acamilo/Motherboard_Controller/SmallKat v2.kicad_pcb

## KiCad design SmallKat v2.kicad_pcb (2020-02-04)

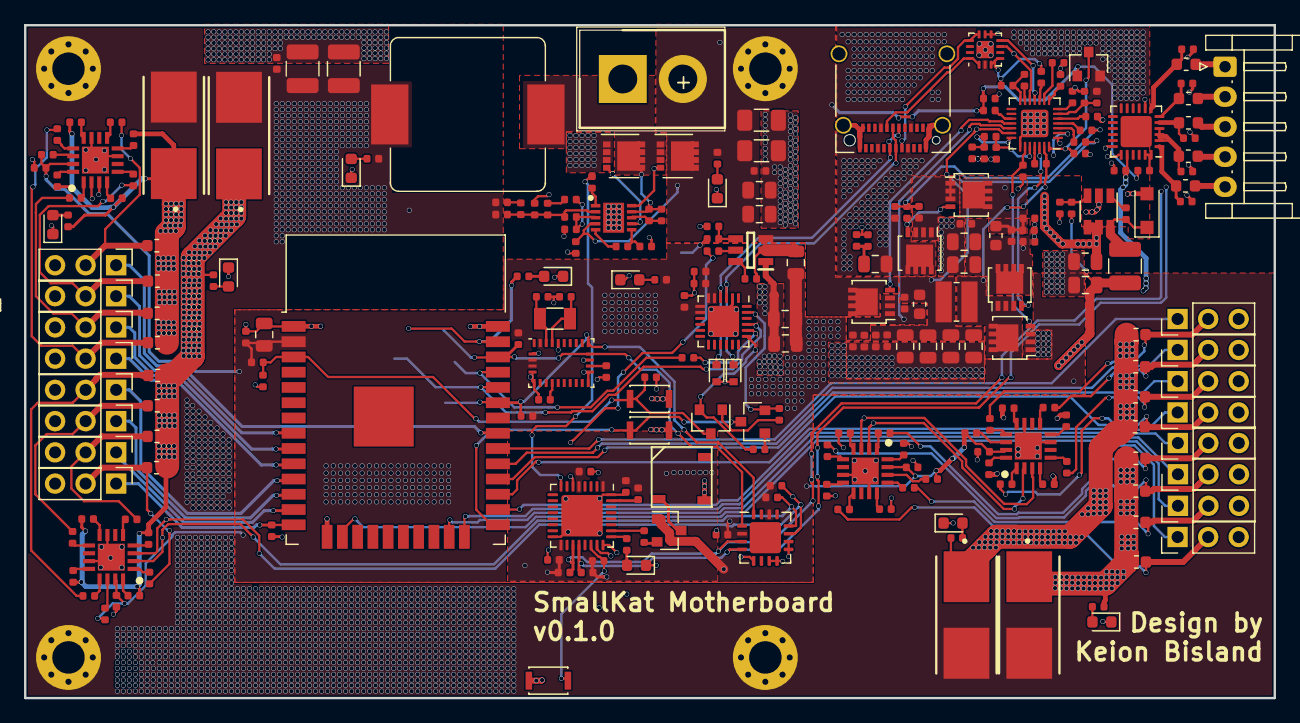
[picture p1: board SmallKat v2.kicad_pcb from above]

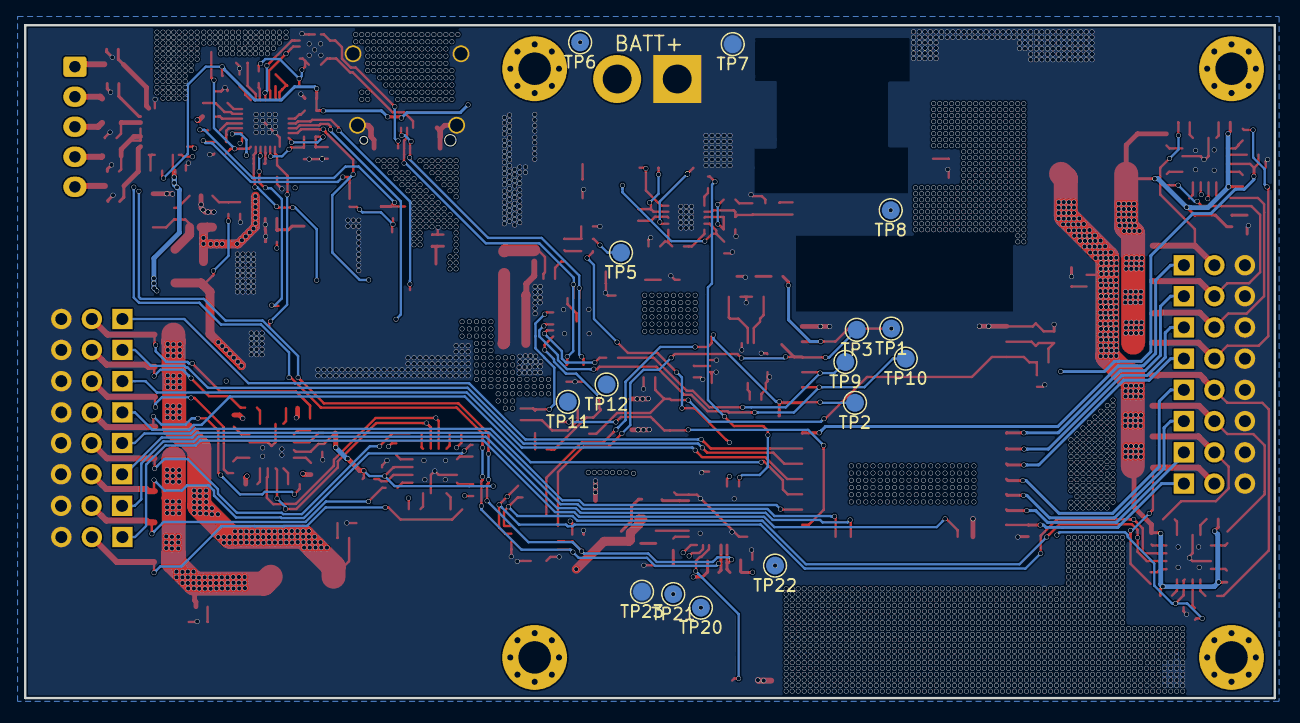
[picture p2: board SmallKat v2.kicad_pcb from below]

Board: 4 copper layers, 104.0 x 56.0 mm, 272 parts (15 on the bottom side), 177 nets.

Parts:
BZ1: Buzzer; KLJ-5030
C1, C2, C35, C63, C66: 10uF; C_0805_2012Metric
C3, C5, C24, C72, C75, C76, C77: 22uF; C_0805_2012Metric
C4, C6, C7, C17, C20, C25, C26, C28, C29, C31, C32, C37, C45, C46, C49, C51, C52, C53, C54, C55, C57, C59, C64, C70, C71, C73, C78, C79, C80: 0.1uF; C_0402_1005Metric
C8, C9: 10pF; C_0402_1005Metric
C10: 1000pF; C_0402_1005Metric
C11, C56, C58: 100pF; C_0402_1005Metric
C12: 10nF; C_0402_1005Metric
C13, C22, C50, C60, C61, C65, C81, C82: 1uF; C_0402_1005Metric
C14, C27: 4.7uF; C_0402_1005Metric
C15: 470nF; C_0402_1005Metric
C16, C18: 10uF; C_1206_3216Metric
C19, C21: 100uF; C_1210_3225Metric
C23, C47: 2.2uF; C_0805_2012Metric
C48: 2200pF; C_0402_1005Metric
C62: 0.01uF; C_0402_1005Metric
C67: 470pF; C_0402_1005Metric
C68: 0.047uF; C_0402_1005Metric
C69, C74: 10uF; C_0402_1005Metric
D1, D2, D3, D4, D18, D23, D24, D25, D26: LED; LED_0603_1608Metric
D5: BAT54C; SOT-23
D7, D8: D_TVS; D_SOD-523
D17: MA2YD26; D_SOD-123F
F1, F2, F3, F4: Fuse; 0154.250DR
H1, H2, H3, H4: MountingHole_Pad; MountingHole_2.7mm_M2.5_Pad_Via
IC1: TPS562201DDCR; SOT95P280X110-6N
IC2: TPS40192DRCT; SON50P300X300X100-11N
IC4, IC5, IC6, IC7: MAX34409ETE+; QFN65P400X400X80-17N
J1, J2, J3, J4, J5, J6, J7, J8, J10, J11, J12, J13, J14, J15, J16, J17: Conn_01x03_Male; PinHeader_1x03_P2.54mm_Vertical
J9: Conn_01x02_Male; SHDR2W320P716_1X2_1574X813X1588P
J19: USB_C_Receptacle; USB_C_Receptacle_Amphenol_12401610E4-2A_CircularHoles
J21: Conn_01x05_Male; JST_EH_S5B-EH_1x05_P2.50mm_Horizontal
L1: 4.7uH; L_0805_2012Metric
L2: 1uH; L_Bourns_SRP1245A
L3: 15uH; L_1210_3225Metric
L4: L; L_Wuerth_MAPI-3020
Q1, Q2: BUK9M120-100EX; VSON-8_3.3x3.3mm_P0.65mm_NexFET
Q3, Q4: MMBT3904; SOT-23
Q7: 2N3905; SOT-23
Q8, Q9: BUK9M120-100EX; LFPAK33
Q10, Q11: CSD17307Q5A; LFPAK33
Q12: Si7141DP; LFPAK33
R1, R7, R44: 330R; R_0402_1005Metric
R2: 1K; R_0402_1005Metric
R3: 3.4K; R_0402_1005Metric
R4, R5, R8, R10, R11, R21, R25, R26, R27, R43, R45, R46, R47, R48, R56, R117, R119, R125, R126, R127: 10K; R_0402_1005Metric
R6: 120K; R_0402_1005Metric
R9: 33.2K; R_0402_1005Metric
R12: 2.18k; R_0402_1005Metric
R13: 20k; R_0402_1005Metric
R14: 2.61k; R_0402_1005Metric
R15: 4.22k; R_0402_1005Metric
R16: 3.9k; R_0402_1005Metric
R17, R18, R19: 100k; R_0402_1005Metric
R20, R63, R73, R78, R86: 20K; R_0402_1005Metric
R22, R23, R37, R38, R124: 47R; R_0603_1608Metric
R24: 470R; R_0402_1005Metric
R49, R52: 3.9K; R_0402_1005Metric
R50: 430K; R_0402_1005Metric
R51: 66.5K; R_0402_1005Metric
R53: 4.7R; R_0402_1005Metric
R54, R55: 4.02K; R_0402_1005Metric
R57, R61, R62, R69, R70, R74, R75, R79, R80, R87, R88, R91, R92, R99, R100, R104, R105, R123: 0.01R; R_0603_1608Metric
R58: 30.1K; R_0402_1005Metric
R59, R60, R64, R65, R67, R68, R71, R72, R76, R77, R81, R82, R84, R85, R89, R90, R93, R94, R95, R96, R98, R101, R102, R103, R106, R107, R108, R109, R111, R112, R113, R114: 100R; R_0402_1005Metric
R66, R83, R97, R110: 0R; R_0402_1005Metric
R118: 3M; R_0402_1005Metric
R120: 316K; R_0402_1005Metric
R121: 100K; R_0402_1005Metric
R122: 10R; R_0402_1005Metric
SW1, SW2, SW5: SW_SPST; SW_SPST_CK_KXT3
TP1, TP2, TP3, TP5, TP6, TP7, TP8, TP9, TP10, TP11, TP12, TP20, TP21, TP22, TP23: TestPoint; TestPoint_Pad_D1.5mm
U1: BNO055; LGA-28_5.2x3.8mm_P0.5mm
U2: LM2840Y; TSOT-23-6
U3: ESP32-WROOM-32
U4: CP2102N-A01-GQFN24; QFN-24-1EP_4x4mm_P0.5mm_EP2.6x2.6mm
U6: STM32L432KBUx; QFN-32-1EP_5x5mm_P0.5mm_EP3.45x3.45mm
U11: FUSB302BMPX; WQFN-14-1EP_2.5x2.5mm_P0.5mm_EP1.45x1.45mm
U12: BQ24770; QFN-28-1EP_4x4mm_P0.4mm_EP2.3x2.3mm
U13: bq76925; QFN-24-1EP_4x4mm_P0.5mm_EP2.6x2.6mm
U14: PCA9641; UQFN-16-1EP_4x4mm_P0.65mm_EP2.6x2.6mm
Y1: 32.768kHz; Crystal_SMD_3215-2Pin_3.2x1.5mm

Connections:
+3.3VA: C35.1, C37.1, C45.1, C46.1, L3.2, R3.1, R43.2, R45.1, R46.1, R48.1, TP22.1, U6.1, U6.5, U6.17
+3V3: C3.1, C5.1, C24.1, C26.1, C27.1, C28.1, C29.2, C52.1, C53.1, C54.1, C55.1, C81.1, C82.1, IC4.15, IC5.15, IC6.15, IC7.15, L1.1, Q7.1, R4.2, R5.2, R7.1, R9.1, R27.1, R56.2, R66.1, R83.1, R97.1, R110.1, R117.2, R119.1, R126.1, R127.1, TP5.1, U1.3, U1.4, U1.28, U3.2, U4.5, U4.6, U4.7, U4.8, U11.3, U11.4, U13.20, U14.2, U14.14
+6V: C10.1, C19.1, C21.1, C22.1, F1.2, F2.2, F3.2, F4.2, H1.1, H2.1, H4.1, L2.2, R13.1, R20.1, TP8.1
+BATT: C1.2, C2.2, C4.2, C13.1, C16.1, C18.1, C64.1, D5.1, H3.1, IC1.3, IC2.4, J9.2, Q1.5, Q12.5, R6.1, R122.1, R125.2, TP6.1
/MainBoard/3.3VEN: R10.1, U6.6
/MainBoard/6VEN: R17.1, U6.8
/MainBoard/BatteryBalancer/C0: J21.1, R124.2
/MainBoard/BatteryBalancer/C1: J21.2, R38.2
/MainBoard/BatteryBalancer/C2: J21.3, R37.2
/MainBoard/BatteryBalancer/C3: J21.4, R23.2
/MainBoard/BatteryBalancer/C4: J21.5, R22.2
/MainBoard/CC1: J19.A5, U11.10, U11.11
/MainBoard/CC2: J19.B5, U11.1, U11.14
/MainBoard/ESP32Module/DTR: Q4.2, R25.2, TP11.1, U4.23
/MainBoard/ESP32Module/EN: C31.1, C32.1, Q3.3, R27.2, SW2.2, U3.3
/MainBoard/ESP32Module/IO0: Q4.3, SW1.2, U3.25
/MainBoard/ESP32Module/IO23: R1.1, TP1.1, U3.37
/MainBoard/ESP32Module/RTS: Q3.2, R26.2, TP12.1, U4.19
/MainBoard/ESP32Module/RXD: TP10.1, U3.34, U4.21
/MainBoard/ESP32Module/TXD: R24.1, TP9.1, U3.35
/MainBoard/ESP32Module/USBD_N: D7.1, J19.A7, J19.B7, U4.4
/MainBoard/ESP32Module/USBD_P: D8.1, J19.A6, J19.B6, U4.3
/MainBoard/SAFETYSCL: R45.2, U6.19, U11.6, U12.12, U13.19, U14.3
/MainBoard/SAFETYSDA: R46.2, U6.20, U11.7, U12.11, U13.18, U14.4
/MainBoard/SCL: R4.1, TP3.1, U1.19, U3.36, U14.1
/MainBoard/SDA: R5.1, TP2.1, U1.20, U3.33, U14.16
/MainBoard/SERVO0: J1.1, R21.1, U3.14
/MainBoard/SERVO1: J3.1, U3.13
/MainBoard/SERVO2: J5.1, U3.12
/MainBoard/SERVO3: J7.1, U3.11
/MainBoard/SERVO4: J10.1, U3.10
/MainBoard/SERVO5: J12.1, U3.9
/MainBoard/SERVO6: J14.1, U3.8
/MainBoard/SERVO7: J16.1, U3.31
/MainBoard/SERVO8: J2.1, U3.16
/MainBoard/SERVO9: J4.1, U3.23
/MainBoard/SERVO10: J6.1, U3.24
/MainBoard/SERVO11: J8.1, U3.26
/MainBoard/SERVO12: J11.1, U3.27
/MainBoard/SERVO13: J13.1, U3.28
/MainBoard/SERVO14: J15.1, U3.29
/MainBoard/SERVO15: J17.1, U3.30
/MainBoard/SafetyMCU/BUZZER: R47.2, U6.26
/MainBoard/SafetyMCU/MONITORING: R44.1, U6.25
/MainBoard/SafetyMCU/SOFTPOWER: R48.2, SW5.2, U6.22
/MainBoard/Servos/6V1: F1.1, R60.2, R61.2, R63.1, R65.2, R67.2, R69.2, R71.2, R74.2, R79.2
/MainBoard/Servos/6V2: F2.1, R73.1, R77.2, R82.2, R84.2, R87.2, R89.2, R91.2, R99.2, R104.2
/MainBoard/Servos/6V3: F3.1, R62.2, R70.2, R75.2, R78.1, R80.2, R94.2, R96.2, R98.2, R102.2
/MainBoard/Servos/6V4: F4.1, R86.1, R88.2, R92.2, R100.2, R105.2, R107.2, R109.2, R111.2, R113.2
/MainBoard/Servos/S1: J1.2, R59.2, R61.1
/MainBoard/Servos/S2: J3.2, R64.2, R69.1
/MainBoard/Servos/S3: J5.2, R72.2, R74.1
/MainBoard/Servos/S4: J7.2, R68.2, R79.1
/MainBoard/Servos/S5: J10.2, R85.2, R87.1
/MainBoard/Servos/S6: J12.2, R76.2, R91.1
/MainBoard/Servos/S7: J14.2, R81.2, R99.1
/MainBoard/Servos/S8: J16.2, R90.2, R104.1
/MainBoard/Servos/S9: J2.2, R62.1, R103.2
/MainBoard/Servos/S10: J4.2, R70.1, R101.2
/MainBoard/Servos/S11: J6.2, R75.1, R95.2
/MainBoard/Servos/S12: J8.2, R80.1, R93.2
/MainBoard/Servos/S13: J11.2, R88.1, R106.2
/MainBoard/Servos/S14: J13.2, R92.1, R108.2
/MainBoard/Servos/S15: J15.2, R100.1, R114.2
/MainBoard/Servos/S16: J17.2, R105.1, R112.2
/MainBoard/Sheet5DD4BDB8/ACDET: R50.2, R51.1, U12.6
/MainBoard/Sheet5DD4BDB8/ACDRV: R54.2, U12.4
/MainBoard/Sheet5DD4BDB8/BATDRV: Q12.4, U12.18
/MainBoard/Sheet5DD4BDB8/BTST: C68.2, U12.25
/MainBoard/Sheet5DD4BDB8/CMSRC: R55.2, U12.3
/MainBoard/Sheet5DD4BDB8/HIDRV: Q10.4, U12.26
/MainBoard/Sheet5DD4BDB8/LODRV: C67.1, Q11.4, U12.23
/MainBoard/Sheet5DD4BDB8/PHASE: C68.1, L4.1, Q10.1, Q10.2, Q10.3, Q11.5, U12.27
/MainBoard/Sheet5DD4BDB8/REGN: C65.1, R120.1, U12.24
/MainBoard/Sheet5DD4BDB8/SRN: C71.1, C73.2, C74.1, Q12.1, Q12.2, Q12.3, R123.1, U12.19
/MainBoard/Sheet5DD4BDB8/SRP: C69.1, C70.2, C71.2, C72.1, C75.1, C76.1, C77.1, L4.2, R123.2, U12.20
/MainBoard/Sheet5DD4BDB8/VCC28: C60.2, D5.3, U12.28
/MainBoard/_SCL: IC4.3, IC5.3, IC6.3, IC7.3, R127.2, U14.11
/MainBoard/_SDA: IC4.2, IC5.2, IC6.2, IC7.2, R126.2, U14.12
GND: BZ1.2, C1.1, C2.1, C3.2, C4.1, C5.2, C7.1, C8.1, C9.1, C13.2, C14.2, C16.2, C17.2, C18.2, C19.2, C20.2, C21.2, C22.2, C23.2, C24.2, C26.2, C27.2, C28.2, C29.1, C31.2, C32.2, C35.2, C37.2, C45.2, C46.2, C50.1, C51.1, C52.2, C53.2, C54.2, C55.2, C56.2, C58.2, C59.1, C60.1, C61.2, C62.1, C63.2, C64.2, C65.2, C66.2, C67.2, C69.2, C70.1, C72.2, C73.1, C74.2, C75.2, C76.2, C77.2, C78.2, C79.2, C80.2, C81.2, C82.2, D1.1, D2.1, D3.1, D4.1, D7.2, D8.2, D17.2, D18.1, D23.1, D24.1, D25.1, D26.1, IC1.1, IC2.11, IC4.7, IC4.11, IC4.17, IC5.7, IC5.11, IC5.17, IC6.7, IC6.11, IC6.17, IC7.7, IC7.11, IC7.17, J1.3, J2.3, J3.3, J4.3, J5.3, J6.3, J7.3, J8.3, J9.1, J10.3, J11.3, J12.3, J13.3, J14.3, J15.3, J16.3, J17.3, J19.A1, J19.A12, J19.B1, J19.B12, J19.S1, Q2.1, Q2.2, Q2.3, Q11.1, Q11.2, Q11.3, R2.2, R8.1, R11.2, R12.2, R16.2, R21.2, R49.2, R51.2, R52.2, R58.2, R121.1, SW1.1, SW2.1, SW5.1, TP7.1, TP23.1, U1.2, U1.5, U1.6, U1.15, U1.16, U1.18, U1.25, U2.2, U3.1, U3.15, U3.38, U3.39, U4.2, U4.25, U6.16, U6.32, U6.33, U11.8, U11.9, U11.15, U12.22, U12.29, U13.8, U14.5, U14.7, U14.8, U14.9, U14.10
unnamed: BZ1.1, Q7.3
unnamed: C6.1, IC1.6
unnamed: C6.2, IC1.2, L1.2
unnamed: C7.2, U1.9
unnamed: C8.2, U1.26, Y1.1
unnamed: C9.2, U1.27, Y1.2
unnamed: C10.2, R14.2
unnamed: C11.1, C12.1, IC2.3, R16.1
unnamed: C11.2, IC2.2, R12.1, R13.2, R14.1, R15.2
unnamed: C12.2, R15.1
unnamed: C14.1, IC2.6, R18.1
unnamed: C15.1, IC2.9, L2.1, Q1.1, Q1.2, Q1.3, Q2.5, R19.1
unnamed: C15.2, IC2.8, R19.2
unnamed: C17.1, R22.1, U13.1
unnamed: C20.1, R23.1, U13.2, U13.3, U13.4
unnamed: C25.1, D17.1, L3.1, U2.6
unnamed: C25.2, U2.1
unnamed: C47.2, R49.1, R52.1
unnamed: C48.2, C49.2, R53.2, R54.1
unnamed: C49.1, Q8.1, Q8.2, Q8.3, Q9.1, Q9.2, Q9.3, R55.1
unnamed: C50.2, C51.2, C57.2, Q9.5, R57.2, U12.2
unnamed: C56.1, U12.7
unnamed: C57.1, C59.2, C61.1, C63.1, C66.1, Q10.5, R57.1, U12.1
unnamed: C58.1, U12.8
unnamed: C62.2, R120.2, R121.2, U12.21
unnamed: C78.1, R37.1, U13.5
unnamed: C79.1, R38.1, U13.6
unnamed: C80.1, R124.1, U13.7
unnamed: D1.2, R1.2
unnamed: D2.2, R6.2
unnamed: D3.2, R7.2
unnamed: D4.2, R20.2
unnamed: D18.2, R44.2
unnamed: D23.2, R63.2
unnamed: D24.2, R73.2
unnamed: D25.2, R78.2
unnamed: D26.2, R86.2
unnamed: IC1.4, R8.2, R9.2
unnamed: IC1.5, R10.2
unnamed: IC2.1, R17.2
unnamed: IC2.5, R18.2
unnamed: IC2.7, Q2.4
unnamed: IC2.10, Q1.4
unnamed: IC4.1, R59.1
unnamed: IC4.4, R60.1
unnamed: IC4.5, R64.1
unnamed: IC4.8, R67.1
unnamed: IC4.9, R72.1
unnamed: IC4.12, R71.1
unnamed: IC4.13, R68.1
unnamed: IC4.14, R66.2
unnamed: IC4.16, R65.1
unnamed: IC5.1, R76.1
unnamed: IC5.4, R77.1
unnamed: IC5.5, R81.1
unnamed: IC5.8, R84.1
unnamed: IC5.9, R90.1
unnamed: IC5.12, R89.1
unnamed: IC5.13, R85.1
unnamed: IC5.14, R83.2
unnamed: IC5.16, R82.1
unnamed: IC6.1, R93.1
unnamed: IC6.4, R94.1
unnamed: IC6.5, R95.1
unnamed: IC6.8, R98.1
unnamed: IC6.9, R103.1
unnamed: IC6.12, R102.1
unnamed: IC6.13, R101.1
unnamed: IC6.14, R97.2
unnamed: IC6.16, R96.1
unnamed: IC7.1, R106.1
unnamed: IC7.4, R107.1
unnamed: IC7.5, R108.1
unnamed: IC7.8, R111.1
unnamed: IC7.9, R114.1
unnamed: IC7.12, R113.1
unnamed: IC7.13, R112.1
unnamed: IC7.14, R110.2
unnamed: IC7.16, R109.1
unnamed: Q3.1, R25.1
unnamed: Q4.1, R26.1
unnamed: Q7.2, R47.1
unnamed: Q8.4, Q9.4, R53.1
unnamed: R2.1, R3.2, U2.3
unnamed: R11.1, U1.17
unnamed: R24.2, U4.20
unnamed: R43.1, U6.31
unnamed: R56.1, U12.5
unnamed: R58.1, U12.9
unnamed: R117.1, U12.10
unnamed: R118.1, U12.13
unnamed: R118.2, R119.2, U12.14
unnamed: R122.2, U12.17
unnamed: R125.1, U13.23, U13.24
unnamed: TP20.1, U6.23
unnamed: TP21.1, U6.24
VBUS: C23.1, C47.1, C48.1, D5.2, J19.A4, J19.A9, J19.B4, J19.B9, Q8.5, R50.1, U2.4, U2.5, U11.2
